adafruit/Adafruit-VL53L1X-PCB/Adafruit VL53L1X.brd

## EAGLE design Adafruit VL53L1X.brd (2021-10-26)

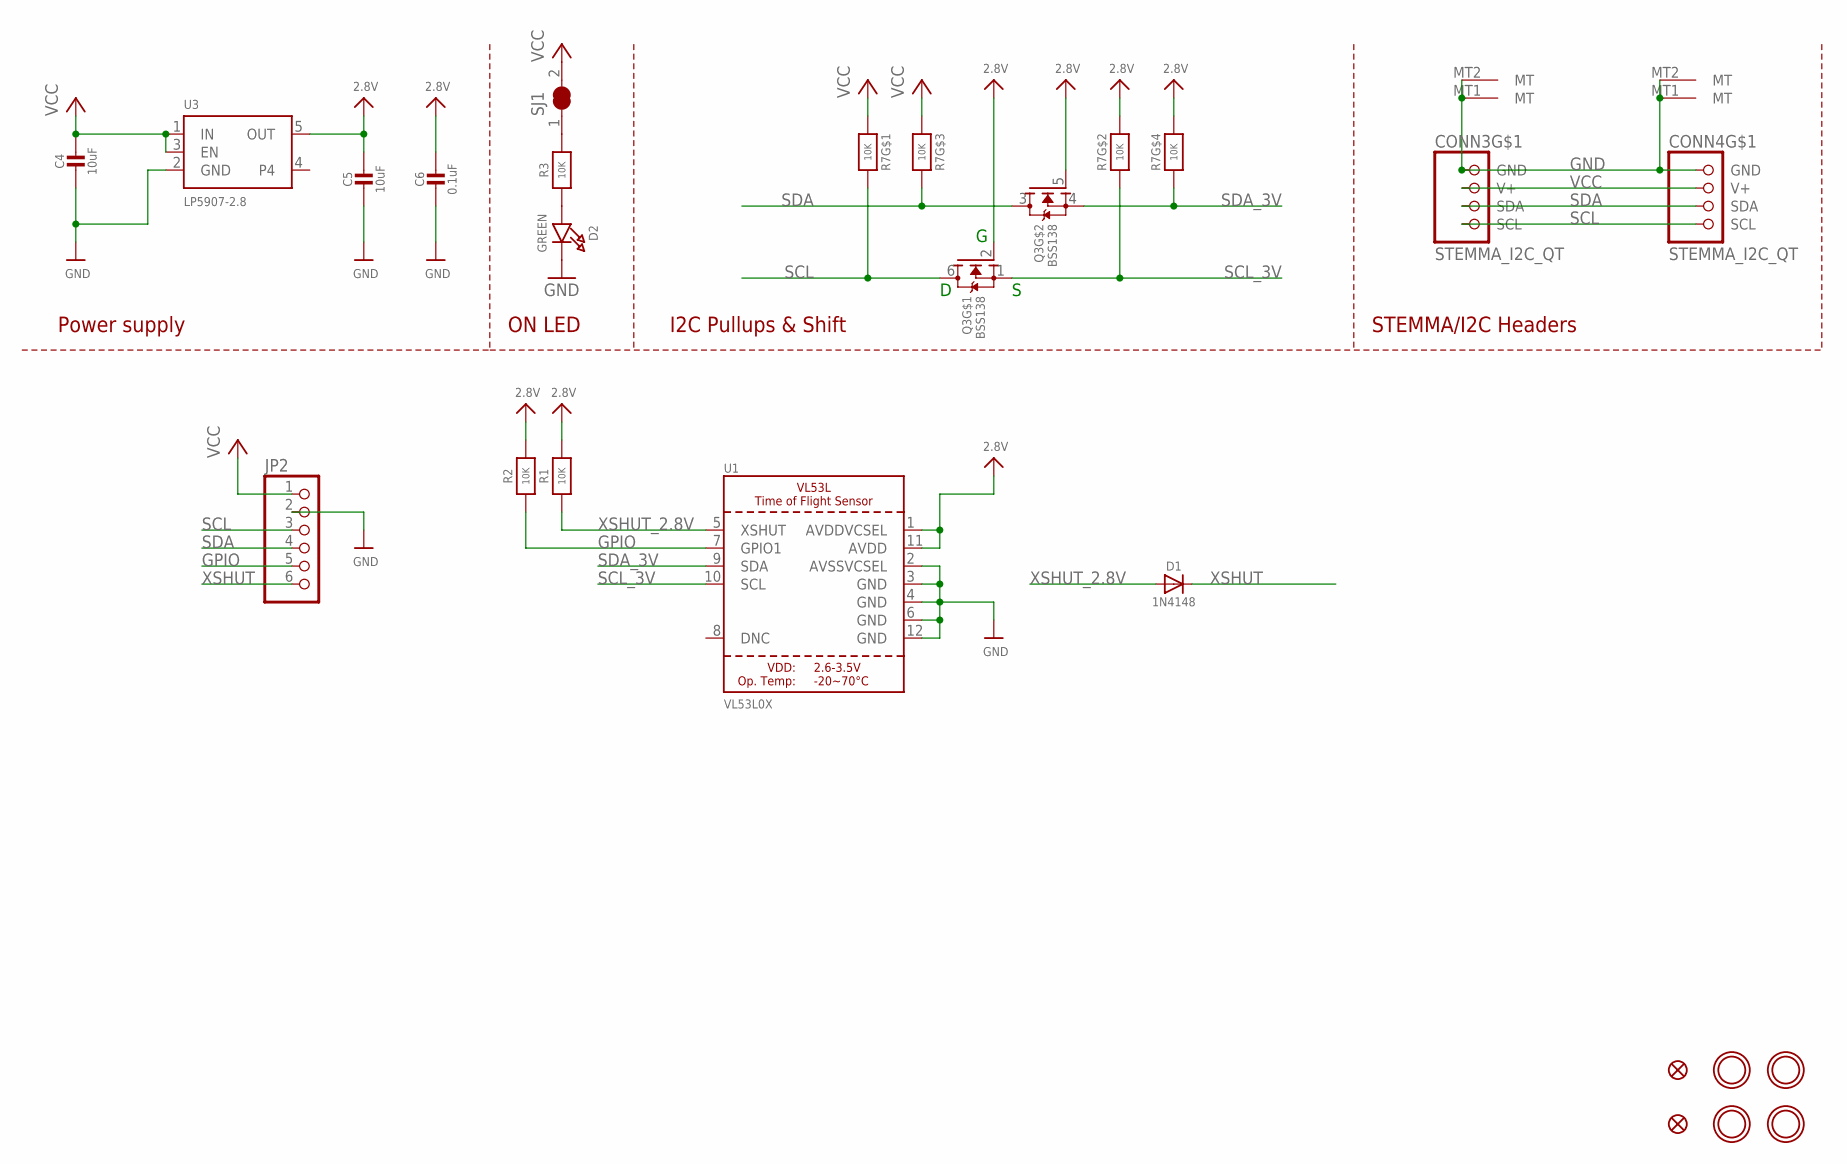
[picture p2: schematic Adafruit VL53L1X.sch]

Parts:
C4, C5: 10uF; 0805-NO
C6: 0.1uF; 0603-NO
CONN3, CONN4: STEMMA_I2C_QT; JST_SH4
D1: 1N4148; SOD-323
D2: GREEN; CHIPLED_0603_NOOUTLINE
FID1, FID4: FIDUCIAL_1MM
JP2: HEADER-1X670MIL; 1X06_ROUND_70
Q3: BSS138; SOT363
R1, R2, R3: 10K; 0603-NO
R7: 10K; RESPACK_4X0603
SJ1: SOLDERJUMPER_CLOSED; SOLDERJUMPER_CLOSEDWIRE
U1: VL53L0X; LGA12_ST
U3: LP5907-2.8; SOT23-5
U$30, U$31, U$33, U$34: MOUNTINGHOLE2.5; MOUNTINGHOLE_2.5_PLATED

Connections:
2.8V: C5.1, C6.1, Q3.2 (G), Q3.5 (G), R1.2, R2.2, R7.2 (1), R7.4 (1), U1.1 (AVDDVCSEL), U1.11 (AVDD), U3.5 (OUT)
GND: C4.2, C5.2, C6.2, CONN3.1 (GND), CONN3.MT1 (MT), CONN3.MT2 (MT), CONN4.1 (GND), CONN4.MT1 (MT), CONN4.MT2 (MT), D2.C, JP2.2, U1.2 (AVSSVCSEL), U1.3 (GND), U1.4 (GND), U1.6 (GND), U1.12 (GND), U3.2 (GND)
GPIO: JP2.5, R2.1, U1.7 (GPIO1)
unnamed: D2.A, R3.1
unnamed: R3.2, SJ1.1
SCL: CONN3.4 (SCL), CONN4.4 (SCL), JP2.3, Q3.6 (D), R7.8 (2)
SCL_3V: Q3.1 (S), R7.7 (2), U1.10 (SCL)
SDA: CONN3.3 (SDA), CONN4.3 (SDA), JP2.4, Q3.3 (D), R7.6 (2)
SDA_3V: Q3.4 (S), R7.5 (2), U1.9 (SDA)
VCC: C4.1, CONN3.2 (V+), CONN4.2 (V+), JP2.1, R7.1, R7.3 (1), SJ1.2, U3.1 (IN), U3.3 (EN)
XSHUT: D1.C, JP2.6
XSHUT_2.8V: D1.A, R1.1, U1.5 (XSHUT)

Notes on the sheet:
I2C Pullups & Shift
STEMMA/I2C Headers
ON LED
Power supply

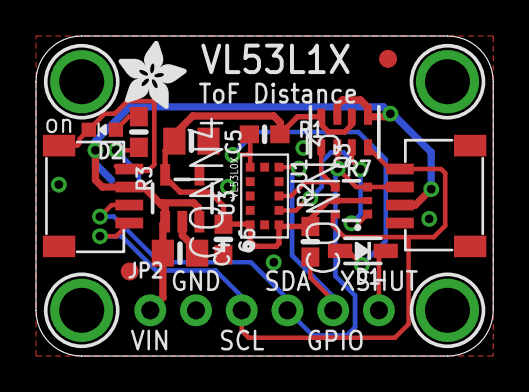
[picture p3: board Adafruit VL53L1X.brd from above]

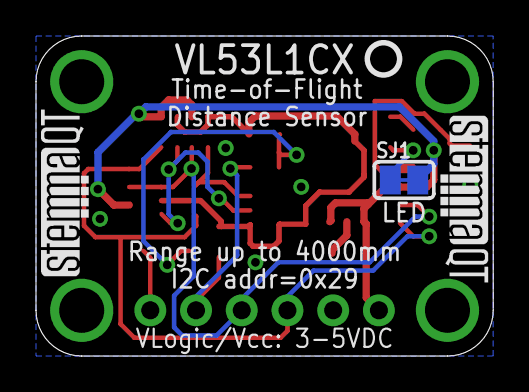
[picture p4: board Adafruit VL53L1X.brd from below]

Board: 2 copper layers, 25.4 x 17.8 mm, 26 parts (4 on the bottom side), 12 nets.

Other parts of the board:
U$36: ADAFRUIT_3.5MM
U$37: PCBFEAT-REV-040
U$38, U$39: STEMMAQT
