adafruit/Adafruit-VL53L1X-PCB/(threads)

Thread 1 (2022-10-01):

Design Question: Why 2.8V?

johnrbnsn, 2022-10-01:
Hi, I'm looking at the schematic and curious why you would use 2.8V and not 3.3V that many microcontrollers use? Is it just to allow I2C to work with any potentially lower (2.8V) devices? If you were to design a circuit with this on the same board as a 3.3V uC, is there any reason to use 2.8V or would you just stick with 3.3V?
